SattiDaBeaver/System-From-Scratch/docs/01_architecture.md

# High-level:

## Word size

## Endianness
- Little Endian

## Memory Map

| Base Address | End Address  | Size | Description |
|---|---|---|---|
| `0x00000000` | `0x00003FFF` | 16KB | DP BRAM (boot + program) |
| `0x10000000` | `0x10000000` | 4B | UART TX data |
| `0x10000004` | `0x10000004` | 4B | UART RX data |
| `0x10000008` | `0x10000008` | 4B | UART status (bit 0 = TX_busy, bit 1 = RX_done) |
| `0x20000000` | `0x20000000` | 4B | VGA_CTRL (bit0 = DOUBLE_BUF_EN, bit1 = SWAP) |
| `0x20000004` | `0x20000004` | 4B | VGA_STATUS, read-only (bit0 = SWAP_PENDING) |
| `0x20001000` | `0x20001FFF` | 4KB page (2400B used) | VGA draw buffer -- fixed logical address, remapped internally by `vga_framebuffer.sv` to whichever physical buffer software should be drawing into (the scanned-out buffer in single-buffer mode, the back buffer in double-buffer mode) |
| `0x20002000` | `0x20002FFF` | 4KB page (2400B used) | VGA debug-peek buffer -- fixed logical address, always maps to the physical buffer NOT currently mapped at the draw address; lets `reg_debugger.py` READ_MEM inspect the other buffer regardless of mode |
| `0x30000000` | `0x30000000` | 4B | Timer RELOAD (rw) |
| `0x30000004` | `0x30000004` | 4B | Timer CTRL (rw, bit0 = EN) |
| `0x30000008` | `0x30000008` | 4B | Timer STATUS (bit0 = pending, write-1-to-clear) |

### VGA framebuffer (`src/peripherals/vga_framebuffer.sv`)

160x120, 1bpp (monochrome), two physical buffers (double-buffer capable,
~2.4KB each / ~4.8KB total -- negligible against MAX10 10M50's ~200KB
M9K budget). Row-major, row stride 5 words (20B): pixel `(x,y)` -> word
`y*5 + x/32`, bit `x%32`. Self-contained module -- owns both physical
buffers, the draw/debug-peek address remapping, and VGA timing/scanout
internally; the top level only wires a slice of the dmem bus in (same
pattern as `uart_sel`/`debug_uart` today) plus `CLOCK_50`/hsync/vsync/rgb
out, no muxing logic lives in `riscv_top.sv` itself -- designed to be a
drop-in for other CPU-driven-VGA projects, not SoC-specific.

- **Single-buffer mode** (`DOUBLE_BUF_EN=0`): writes to the draw address
  hit the buffer currently being scanned out directly -- real-time,
  visible immediately, tearing possible. Useful for testing/quick
  iteration without waiting on a swap.
- **Double-buffer mode** (`DOUBLE_BUF_EN=1`): writes to the draw address
  hit the back buffer only. Writing `SWAP=1` requests a swap; the actual
  front/back flip is applied on the vsync edge that starts the next
  frame (never mid-scanout, so the swap itself can't tear), at which
  point `SWAP_PENDING` clears. Software's draw loop: draw into the back
  buffer, write `SWAP=1`, poll `SWAP_PENDING` until it clears, repeat.
- A `SWAP` write in single-buffer mode is a no-op (nothing to swap, not
  an error) -- lets software leave a `SWAP=1` write in place when
  toggling `DOUBLE_BUF_EN` without needing to special-case it.
- Clocking: the module runs directly off `CLOCK_50` (50MHz), not the
  divided-down 25MHz clock the core/UART/BRAM use -- an internal
  `CLK_DIV` parameter (default 2) generates a pixel-rate enable that
  gates only the H/V timing counters/scanout, not the bus-facing
  register/buffer read/write logic (which runs every `clk50` edge,
  unthrottled). No CDC synchronizers on the dmem-bus inputs: the core's
  `clk` is itself a toggle-FF driven directly off `clk50` (mesochronous,
  not truly asynchronous), so `clk50`-domain logic samples core-driven
  signals directly. Both physical buffers are `dp_ram_sync_read`
  instances (synchronous-read/write dual-port RAM, `src/peripherals/
  dp_ram_sync_read.sv`), not raw arrays, so Quartus reliably infers block
  RAM. Draw/peek buffer reads take 2 cycles (RAM's own registered
  output + an outer decode-delay register); VGA_CTRL/VGA_STATUS reads
  take the same 2 cycles for a uniform read contract.

## Register count

## Address space layout

## Interrupt model

Synchronous exceptions only: ECALL/EBREAK trap entry (mepc <- trapping
pc, mcause <- 11/3, pc <- mtvec) and MRET trap exit (pc <- mepc) are
implemented on both cores. On the pipelined core they resolve in EX like
a known-unconditional jump (folded into `ex_flush`/`next_pc`), with a
stall added ahead of them in ID for any still-in-flight CSR write to the
same `mtvec`/`mepc` they read.

Timer interrupts (pipelined core only): `src/peripherals/timer.sv` is a
simple periodic down-counter (RELOAD/CTRL.EN/STATUS.pending register
map at `0x30000000`, see the memory map above) that drives a level `irq`
output, wired into `riscv_core.sv` as `timer_irq` and mirrored
combinationally into `mip` bit 7 (MTIP). `irq_taken` is level-driven
(`mstatus.MIE && mie.MTIE && timer_irq`) rather than tied to a specific
instruction, checked against whatever instruction is currently resolving
in EX; it is gated only by an in-progress ECALL/EBREAK/MRET (never by an
ordinary taken branch/jal/jalr, since a tight self-loop resolves as a
taken jal every cycle and would otherwise make the interrupt
unreachable while spinning). A taken interrupt redirects to `mtvec`
(same vector traps already use -- no vectored mode), sets `mcause` to
`0x80000007` (machine timer interrupt), and stacks `mstatus`: `MPIE <-
MIE`, `MIE <- 0` on entry, restored (`MIE <- MPIE`, `MPIE <- 1`) on
MRET, so a handler can't be re-interrupted until it explicitly returns.

Not yet implemented: `mstatus` MIE/MPIE stacking and timer-interrupt
support on the frozen single-cycle core (`riscv_core_single_cycle.sv`)
-- deliberately out of scope for this pass, see `docs/04_pipeline_plan.md`
-- and any real privilege modes.

## Target clock frequency
