SattiDaBeaver/System-From-Scratch/fpga/riscv_top.sv

// CORE_TYPE selects which core RTL gets elaborated -- "PIPELINED" (default)
// for the in-development 5-stage riscv_core, or "SINGLE_CYCLE" for the
// frozen riscv_core_single_cycle golden model (see test/testbench/tb_diff.sv,
// which already differential-fuzzes the two side by side). Both modules
// share an identical port list, so this is a pure synthesis-time choice --
// no other RTL in this file depends on which one is selected. Override via
// Quartus's top-level parameter assignment (Assignment Editor, or
// `set_parameter -name CORE_TYPE "SINGLE_CYCLE"` in the QSF) before compiling.
module riscv_top #(
    parameter CORE_TYPE = "PIPELINED"
) (
    input  logic [9:0] SW,
    input  logic [1:0] KEY,
    input  logic       CLOCK_50,

    output logic [6:0] HEX5,
    output logic [6:0] HEX4,
    output logic [6:0] HEX3,
    output logic [6:0] HEX2,
    output logic [6:0] HEX1,
    output logic [6:0] HEX0,
    output logic [9:0] LEDR,

    output logic [3:0] VGA_R,
    output logic [3:0] VGA_G,
    output logic [3:0] VGA_B,
    output logic       VGA_HS,
    output logic       VGA_VS,

    inout  logic [15:0] ARDUINO_IO
);

    // ──────────────────────────────────────
    //  Clock and Reset
    // ──────────────────────────────────────
    // Single 25MHz system clock for everything (core, both UARTs, BRAM) --
    // the single-cycle core can't close timing at the full 50MHz CLOCK_50,
    // so rather than keep a separate core_clk/clk split (which needs a
    // clock-domain-crossing-aware STEP pulse for the debug UART), just
    // divide once and run the whole design off the divided clock. No CDC
    // anywhere in this design as a result.
    logic clk50;
    logic clk;
    logic rst;
    logic clk_div_toggle;

    assign clk50 = CLOCK_50;
    assign rst   = ~KEY[0];

    // Free-running, NOT gated by rst: every downstream module's own
    // synchronous reset (always_ff @(posedge clk) if (rst) ...) needs at
    // least one clk edge while rst is still asserted to actually latch its
    // reset values. Gating this divider on rst held clk_div_toggle (and
    // therefore clk) frozen at 0 for the whole reset window, so no
    // downstream sync-reset block ever saw a posedge to reset on -- e.g.
    // debug_uart's halt<=1'b1 on reset silently never took effect, on
    // hardware as well as in sim (see docs/dev_log.md).
    always_ff @(posedge clk50) begin
        clk_div_toggle <= ~clk_div_toggle;
    end

    assign clk = clk_div_toggle;  // CLOCK_50 / 2 = 25MHz

    // ──────────────────────────────────────
    //  Unused outputs tied off for now
    // ──────────────────────────────────────
    // assign HEX5 = 7'h7F;
    // assign HEX4 = 7'h7F;
    // assign HEX3 = 7'h7F;
    // assign HEX2 = 7'h7F;
    // assign HEX1 = 7'h7F;
    // assign HEX0 = 7'h7F;
    // assign LEDR = 10'b0;

    logic vga_hsync, vga_vsync, vga_mono_pixel;

    assign VGA_R  = {4{vga_mono_pixel}};
    assign VGA_G  = {4{vga_mono_pixel}};
    assign VGA_B  = {4{vga_mono_pixel}};
    assign VGA_HS = vga_hsync;
    assign VGA_VS = vga_vsync;

    // ──────────────────────────────────────
    //  Core Interface Wires
    // ──────────────────────────────────────
    logic [31:0] imem_addr;
    logic [31:0] imem_rdata;
    logic [31:0] dmem_addr;
    logic [31:0] dmem_wdata;
    logic        dmem_we;
    logic        dmem_re;
    logic [3:0]  dmem_byteena;
    logic [31:0] ld_data;
    logic [4:0]  dbg_reg_addr;
    logic [31:0] dbg_reg_data;
    logic [31:0] pc_dbg;
    logic        halt;

    // Debug-driven CSR read (async, combinational on the core side).
    logic [11:0] dbg_csr_addr;
    logic [31:0] dbg_csr_data;

    // req/vld memory handshake -- only riscv_core (PIPELINED) has these
    // ports; for CORE_TYPE=SINGLE_CYCLE dmem_req is tied to dmem_re below
    // so dmem_rvalid's trigger is unchanged from today for that branch.
    logic        imem_req;
    logic        dmem_req;

    // Debug-UART-driven BRAM port B access (hardware bootloader) -- see
    // the BRAM port B mux below.
    logic [31:0] dbg_mem_addr;
    logic [31:0] dbg_mem_wdata;
    logic        dbg_mem_we;
    logic        dbg_mem_valid;
    logic [31:0] dbg_mem_rdata;

    // Debug-driven MMIO peripheral read (READ_MMIO) -- see the periph_addr
    // mux below, which steers uart_sel/timer_sel's decode off dbg_mmio_addr
    // instead of dmem_addr while dbg_mmio_valid is high.
    logic [31:0] dbg_mmio_addr;
    logic        dbg_mmio_valid;
    logic [31:0] dbg_mmio_rdata;

    // ──────────────────────────────────────
    //  UART Wires
    // ──────────────────────────────────────
    logic        uart_tx;
    logic        uart_rx;
    logic        uart_tx_en;
    logic        uart_tx_busy;
    logic        uart_tx_done;
    logic        uart_rx_done;
    logic        uart_rx_parity_err;
    logic [7:0]  uart_tx_data;
    logic [7:0]  uart_rx_data;

    // clk_per_bit for 115200 baud @ 25MHz
    // 25_000_000 / 115200 = 217
    localparam CLK_PER_BIT = 16'd217;

    // ──────────────────────────────────────
    //  Debug UART Wires
    // ──────────────────────────────────────
    logic dbg_rx;
    logic dbg_tx;

    // ARDUINO_IO[0] = RX (input), ARDUINO_IO[1] = TX (output) -- single
    // external serial link, shared by both the program UART and the debug
    // UART. SW[0] picks which one is actually connected to the pins, so
    // switching between "talk to my program" and "halt/step/read regs"
    // is a switch flip instead of moving a cable between ARDUINO headers.
    assign uart_rx = SW[0] ? 1'b1 : ARDUINO_IO[0];  // idle-high when not selected
    assign dbg_rx  = SW[0] ? ARDUINO_IO[0] : 1'b1;
    assign ARDUINO_IO[1] = SW[0] ? dbg_tx : uart_tx;

    // ──────────────────────────────────────
    //  Address Decoder
    // ──────────────────────────────────────
    logic bram_sel;
    logic uart_sel;
    logic vga_sel;
    logic timer_sel;

    // Debug READ_MMIO steers uart_sel/timer_sel's decode (and the address
    // fed to those peripherals below) off dbg_mmio_addr instead of
    // dmem_addr while dbg_mmio_valid is high, mirroring how dbg_mem_valid
    // already steers BRAM port B off dbg_mem_addr. Falls back to dmem_addr
    // whenever dbg_mmio_valid is low, so normal core operation is
    // unaffected. VGA is intentionally excluded from this mux -- READ_MMIO
    // doesn't cover it (see debug_uart.sv's header comment) -- so vga_sel
    // stays on dmem_addr unconditionally.
    logic [31:0] periph_addr;
    assign periph_addr = dbg_mmio_valid ? dbg_mmio_addr : dmem_addr;

    assign bram_sel  = (dmem_addr[31:16]   == 16'h0000);    // 0x00000000 - 0x00003FFF
    assign uart_sel  = (periph_addr[31:4]  == 28'h1000000); // 0x10000000 - 0x1000000F
    assign vga_sel   = (dmem_addr[31:16]   == 16'h2000);    // 0x20000000 - 0x2000FFFF
    assign timer_sel = (periph_addr[31:16] == 16'h3000);    // 0x30000000 - 0x3000FFFF

    // ──────────────────────────────────────
    //  Memory-read valid tracking (real BRAM registers its read address,
    //  so imem_rdata/bram_rd_data lag imem_addr/dmem_addr by one cycle --
    //  imem_vld/dmem_vld below feed both cores' native req/vld stall logic.)
    // ──────────────────────────────────────
    logic imem_rvalid;
    logic dmem_rvalid;

    // imem_addr is held stable by both cores while stalled, so "did the
    // address I'm driving into the BRAM change since last cycle" is a
    // well-defined, core-agnostic proxy for "has the one-cycle registered
    // read latency elapsed" -- fixes the KNOWN BUG from
    // docs/04_pipeline_plan.md §6.2, where imem_rvalid was hardwired 1'b1
    // and never actually tracked REGISTERED_ADDR=1 latency.
    logic [31:0] imem_addr_prev;
    logic        imem_addr_changed;

    always_ff @(posedge clk) begin
        imem_addr_prev <= imem_addr;
    end
    assign imem_addr_changed = (imem_addr != imem_addr_prev);

    // Combinational, not registered -- imem_addr_changed already compares
    // this cycle's address against last cycle's, so it's already the
    // one-cycle-latency signal. Registering it again added a spurious
    // extra cycle where imem_rvalid reported valid for stale data right
    // after a jump (two consecutive address changes), letting the core
    // re-execute/skip instructions around jump targets.
    assign imem_rvalid = !imem_addr_changed;

    // Same bug class as imem_rvalid above, but on dmem: dmem_rvalid <= dmem_req
    // only tracked whether *some* request was pending last cycle, not whether
    // THIS address had a cycle to register. Back-to-back dmem ops to different
    // addresses (e.g. a store immediately followed by a load) kept dmem_req
    // high across the address change, so dmem_rvalid was already asserted on
    // the very first cycle of the new address -- the core read stale
    // bram_rd_data from the prior address one cycle too early. Mirror
    // imem_rvalid's address-change tracking instead.
    logic [31:0] dmem_addr_prev;
    logic        dmem_addr_changed;

    always_ff @(posedge clk) begin
        dmem_addr_prev <= dmem_addr;
    end
    assign dmem_addr_changed = (dmem_addr != dmem_addr_prev);
    assign dmem_rvalid = dmem_req && !dmem_addr_changed;

    // ──────────────────────────────────────
    //  Load Data Mux
    // ──────────────────────────────────────
    logic [31:0] bram_rd_data;
    logic [31:0] uart_rd_data;
    logic [31:0] vga_rd_data;
    logic [31:0] timer_rd_data;
    logic        timer_irq;

    // UART read data mux -- indexed off periph_addr so a debug READ_MMIO
    // (which steers uart_sel/periph_addr, see above) reads the same
    // TX/RX/status registers the core itself would see at that address.
    always_comb begin
        uart_rd_data = 32'b0;
        casez (periph_addr[3:2])
            2'b00: uart_rd_data = {24'b0, uart_tx_data};           // TX data
            2'b01: uart_rd_data = {24'b0, uart_rx_data};           // RX data
            2'b10: uart_rd_data = {30'b0, uart_rx_done,
                                           uart_tx_busy};           // status
            default: uart_rd_data = 32'b0;
        endcase
    end

    // Final load data mux
    always_comb begin
        if      (bram_sel)  ld_data = bram_rd_data;
        else if (uart_sel)  ld_data = uart_rd_data;
        else if (vga_sel)   ld_data = vga_rd_data;
        else if (timer_sel) ld_data = timer_rd_data;
        else                ld_data = 32'b0;
    end

    // dbg_mmio_rdata mirrors the same uart_sel/timer_sel result the core's
    // own ld_data mux would produce, but off periph_addr's debug-steered
    // decode -- VGA is intentionally excluded (see periph_addr comment
    // above), so an out-of-range READ_MMIO address reads as 0.
    always_comb begin
        if      (uart_sel)  dbg_mmio_rdata = uart_rd_data;
        else if (timer_sel) dbg_mmio_rdata = timer_rd_data;
        else                dbg_mmio_rdata = 32'b0;
    end

    // ──────────────────────────────────────
    //  UART Write Decode
    // ──────────────────────────────────────
    always_comb begin
        uart_tx_en   = 1'b0;
        uart_tx_data = 8'b0;
        if (uart_sel && dmem_we) begin
            casez (dmem_addr[3:2])
                2'b00: begin
                    uart_tx_data = dmem_wdata[7:0];
                    uart_tx_en   = 1'b1;
                end
                default: ;
            endcase
        end
    end

    // 7 seg display
    logic [3:0] h0;
    logic [3:0] h1;
    logic [3:0] h2;
    logic [3:0] h3;
    logic [3:0] h4;
    logic [3:0] h5;

    hex_display u_hex0 (.value(h0), .HEX(HEX0));
    hex_display u_hex1 (.value(h1), .HEX(HEX1));
    hex_display u_hex2 (.value(h2), .HEX(HEX2));
    hex_display u_hex3 (.value(h3), .HEX(HEX3));
    hex_display u_hex4 (.value(h4), .HEX(HEX4));
    hex_display u_hex5 (.value(h5), .HEX(HEX5));

    assign h0 = imem_rdata[3:0];
    assign h1 = imem_rdata[7:4];
    assign h2 = imem_rdata[11:8];
    assign h3 = imem_rdata[15:12];
    assign h4 = imem_rdata[19:16];
    assign h5 = imem_rdata[23:20];

    assign LEDR[9:0] = {~dbg_rx, ~dbg_tx, 1'b0, imem_addr[8:2]};

    // ──────────────────────────────────────
    //  DP BRAM
    // ──────────────────────────────────────
    // Port B is normally the core's data memory port; while the debug
    // UART is servicing WRITE_MEM/READ_MEM (dbg_mem_valid), it takes over
    // port B instead. debug_uart only ever asserts dbg_mem_valid while
    // halt is set (see debug_uart.sv), so this can't race a running
    // program's own dmem accesses.
    logic [31:0] bram_addr_b;
    logic [31:0] bram_data_b;
    logic        bram_we_b;
    logic [3:0]  bram_byteena_b;

    assign bram_addr_b = dbg_mem_valid ? dbg_mem_addr  : dmem_addr;
    assign bram_data_b = dbg_mem_valid ? dbg_mem_wdata : dmem_wdata;
    assign bram_we_b   = dbg_mem_valid ? dbg_mem_we    : (dmem_we && bram_sel);
    // debug UART's WRITE_MEM is always a full 32-bit word (see
    // debug_uart.sv's mem_wdata assembly), so it always uses a full mask;
    // the core's own dmem_byteena only applies to its own dmem writes.
    assign bram_byteena_b = dbg_mem_valid ? 4'b1111 : dmem_byteena;
    assign dbg_mem_rdata = bram_rd_data;

    dp_ram u_bram (
        .clock      (clk),
        // Port A — instruction fetch
        .address_a  (imem_addr[13:2]),
        .data_a     (32'b0),
        .wren_a     (1'b0),
        .byteena_a  (4'b1111),
        .q_a        (imem_rdata),
        // Port B — data memory / debug-UART hardware bootloader
        .address_b  (bram_addr_b[13:2]),
        .data_b     (bram_data_b),
        .wren_b     (bram_we_b),
        .byteena_b  (bram_byteena_b),
        .q_b        (bram_rd_data)
    );

    // ──────────────────────────────────────
    //  UART
    // ──────────────────────────────────────
    uart #(
        .CLK_BITS    (16),
        .DATA_WIDTH  (8),
        .PARITY_BITS (0),
        .STOP_BITS   (2)
    ) u_uart (
        .clk            (clk),
        .rst            (rst),
        .clk_per_bit    (CLK_PER_BIT),
        .TX_dataIn      (uart_tx_data),
        .TX_en          (uart_tx_en),
        .RX_dataIn      (uart_rx),
        .TX_out         (uart_tx),
        .TX_done        (uart_tx_done),
        .TX_busy        (uart_tx_busy),
        .RX_dataOut     (uart_rx_data),
        .RX_done        (uart_rx_done),
        .RX_parityError (uart_rx_parity_err)
    );

    // ──────────────────────────────────────
    //  VGA Framebuffer
    // ──────────────────────────────────────
    // Runs off the full-rate 50MHz board clock directly (not the divided
    // `clk` the core/UART/BRAM use) -- CLK_DIV=2 internally regenerates
    // the same 25MHz pixel-timing rate this design already relied on, per
    // README.md's clock-divider note. No CDC synchronizers needed on the
    // sel/addr/wdata/we/re inputs below: `clk` is itself just a toggle-FF
    // off `clk50` (see the divider comment above), so it's mesochronous
    // with clk50, not a genuinely independent/asynchronous clock domain.
    vga_framebuffer #(
        .CLK_DIV (2)
    ) u_vga (
        .clk    (clk50),
        .rst    (rst),
        .sel    (vga_sel),
        .addr   (dmem_addr[15:0]),
        .wdata  (dmem_wdata),
        .we     (dmem_we),
        .re     (dmem_re),
        .rdata  (vga_rd_data),
        .hsync  (vga_hsync),
        .vsync  (vga_vsync),
        .mono_pixel (vga_mono_pixel)
    );

    // ──────────────────────────────────────
    //  Timer (interrupt source)
    // ──────────────────────────────────────
    timer u_timer (
        .clk    (clk),
        .rst    (rst),
        .sel    (timer_sel),
        .addr   (periph_addr[3:0]),
        .wdata  (dmem_wdata),
        .we     (dmem_we),
        // OR in dbg_mmio_valid -- timer's own rdata mux gates on re, and
        // the core's dmem_re won't be asserted during a debug READ_MMIO
        // (the core may well be halted), so without this a debug timer
        // peek would always read back 0.
        .re     (dmem_re || dbg_mmio_valid),
        .rdata  (timer_rd_data),
        .irq    (timer_irq)
    );

    // ──────────────────────────────────────
    //  RISC-V Core
    // ──────────────────────────────────────
    // Both cores now share the same req/vld memory-timing contract --
    // imem_req/imem_vld, dmem_req/dmem_vld -- so both stall internally for
    // exactly as long as the BRAM's registered-address latency takes,
    // instead of an external whole-core halt wrapper (see
    // docs/04_pipeline_plan.md §4/§6.1).
    generate
        if (CORE_TYPE == "SINGLE_CYCLE") begin : g_core
            riscv_core_single_cycle u_core (
                .clk        (clk),
                .rst        (rst),
                .halt       (halt & KEY[1]),
                .imem_addr  (imem_addr),
                .imem_rdata (imem_rdata),
                .imem_req   (imem_req),
                .imem_vld   (imem_rvalid),
                .dmem_addr  (dmem_addr),
                .dmem_wdata (dmem_wdata),
                .dmem_we    (dmem_we),
                .dmem_re    (dmem_re),
                .dmem_byteena(dmem_byteena),
                .ld_data    (ld_data),
                .dmem_req   (dmem_req),
                .dmem_vld   (dmem_rvalid),
                .dbg_reg_addr(dbg_reg_addr),
                .dbg_reg_data(dbg_reg_data),
                .dbg_csr_addr(dbg_csr_addr),
                .dbg_csr_data(dbg_csr_data),
                .pc_dbg     (pc_dbg),
                ._bogus     (1'b0)
            );
        end else begin : g_core
            riscv_core u_core (
                .clk        (clk),
                .rst        (rst),
                .halt       (halt & KEY[1]),
                .imem_addr  (imem_addr),
                .imem_rdata (imem_rdata),
                .imem_req   (imem_req),
                .imem_vld   (imem_rvalid),
                .dmem_addr  (dmem_addr),
                .dmem_wdata (dmem_wdata),
                .dmem_we    (dmem_we),
                .dmem_re    (dmem_re),
                .dmem_byteena(dmem_byteena),
                .ld_data    (ld_data),
                .dmem_req   (dmem_req),
                .dmem_vld   (dmem_rvalid),
                .dbg_reg_addr(dbg_reg_addr),
                .dbg_reg_data(dbg_reg_data),
                .dbg_csr_addr(dbg_csr_addr),
                .dbg_csr_data(dbg_csr_data),
                .pc_dbg     (pc_dbg),
                .timer_irq  (timer_irq),
                ._bogus     (1'b0)
            );
        end
    endgenerate

    // ──────────────────────────────────────
    //  Debug UART
    // ──────────────────────────────────────
    // Core, program UART, and debug UART all now share one clk (25MHz) --
    // no more core_clk/clk split, so STEP's one-cycle halt-drop pulse is
    // always exactly one core clock cycle, unconditionally.
    debug_uart #(
        .CLK_BITS (16)
    ) u_debug_uart (
        .clk          (clk),
        .rst          (rst),
        .clk_per_bit  (CLK_PER_BIT),
        .dbg_rx       (dbg_rx),
        .dbg_tx       (dbg_tx),
        .dbg_reg_addr (dbg_reg_addr),
        .dbg_reg_data (dbg_reg_data),
        .pc_dbg       (pc_dbg),
        .dbg_csr_addr (dbg_csr_addr),
        .dbg_csr_data (dbg_csr_data),
        .dbg_mem_addr  (dbg_mem_addr),
        .dbg_mem_wdata (dbg_mem_wdata),
        .dbg_mem_we    (dbg_mem_we),
        .dbg_mem_valid (dbg_mem_valid),
        .dbg_mem_rdata (dbg_mem_rdata),
        .dbg_mmio_addr  (dbg_mmio_addr),
        .dbg_mmio_valid (dbg_mmio_valid),
        .dbg_mmio_rdata (dbg_mmio_rdata),
        .halt         (halt)
    );

endmodule
