SattiDaBeaver/System-From-Scratch/test/testbench/tb_diff.sv

// tests/testbench/tb_diff.sv
//
// Differential testbench: instantiates the core under active development
// (riscv_core, pipelined once that work lands) side by side with the
// frozen, verified riscv_core_single_cycle golden model. Each gets its own
// imem/dmem arrays -- imem is loaded identically into both by the test, and
// dmem starts identical -- so any divergence in dmem contents or regfile
// state after both cores converge (see utils.await_convergence) is a real
// behavioral mismatch, not a shared-state artifact.

module tb_diff #(
    parameter IMEM_DEPTH = 256,   // 256 x 4 bytes = 1KB
    parameter DMEM_DEPTH = 256    // 256 x 4 bytes = 1KB
) (
    input  logic        clk,
    input  logic        rst
);

    // ---- DUT: core under test (pipeline, once implemented) ----
    logic [31:0] imem       [0:IMEM_DEPTH-1];
    logic [31:0] dmem       [0:DMEM_DEPTH-1];
    logic [31:0] imem_addr;
    logic [31:0] imem_rdata;
    logic [31:0] dmem_addr;
    logic [31:0] dmem_wdata;
    logic        dmem_we;
    logic [3:0]  dmem_byteena;
    logic        dmem_re;
    logic [31:0] ld_data;
    logic [4:0]  dbg_reg_addr;
    logic [31:0] dbg_reg_data;
    logic [31:0] pc_dbg;

    // Debug CSR read -- no debug_uart instance here, just expose for
    // direct signal access (dut.u_core.dbg_csr_data), mirroring
    // tb_core.sv's treatment.
    logic [11:0] dbg_csr_addr;
    logic [31:0] dbg_csr_data;

    riscv_core #(
        .ISA ("RV32I")
    ) u_core (
        .clk         (clk),
        .rst         (rst),
        .halt        (1'b0),
        .imem_addr   (imem_addr),
        .imem_rdata  (imem_rdata),
        .imem_req    (),
        .imem_vld    (1'b1),
        .dmem_addr   (dmem_addr),
        .dmem_wdata  (dmem_wdata),
        .dmem_we     (dmem_we),
        .dmem_byteena(dmem_byteena),
        .dmem_re     (dmem_re),
        .ld_data     (ld_data),
        .dmem_req    (),
        .dmem_vld    (1'b1),
        .dbg_reg_addr(dbg_reg_addr),
        .dbg_reg_data(dbg_reg_data),
        .dbg_csr_addr(dbg_csr_addr),
        .dbg_csr_data(dbg_csr_data),
        .pc_dbg      (pc_dbg),
        .timer_irq   (1'b0)
    );

    assign imem_rdata = imem[imem_addr[31:2]];
    assign ld_data    = dmem[dmem_addr[31:2]];

    always_ff @(posedge clk) begin
        if (dmem_we) begin
            if (dmem_byteena[0]) dmem[dmem_addr[31:2]][7:0]   <= dmem_wdata[7:0];
            if (dmem_byteena[1]) dmem[dmem_addr[31:2]][15:8]  <= dmem_wdata[15:8];
            if (dmem_byteena[2]) dmem[dmem_addr[31:2]][23:16] <= dmem_wdata[23:16];
            if (dmem_byteena[3]) dmem[dmem_addr[31:2]][31:24] <= dmem_wdata[31:24];
        end
    end

    // ---- Golden model: frozen pre-pipeline single-cycle core ----
    logic [31:0] imem_ref       [0:IMEM_DEPTH-1];
    logic [31:0] dmem_ref       [0:DMEM_DEPTH-1];
    logic [31:0] imem_addr_ref;
    logic [31:0] imem_rdata_ref;
    logic [31:0] dmem_addr_ref;
    logic [31:0] dmem_wdata_ref;
    logic        dmem_we_ref;
    logic [3:0]  dmem_byteena_ref;
    logic        dmem_re_ref;
    logic [31:0] ld_data_ref;
    logic [4:0]  dbg_reg_addr_ref;
    logic [31:0] dbg_reg_data_ref;
    logic [31:0] pc_dbg_ref;

    logic [11:0] dbg_csr_addr_ref;
    logic [31:0] dbg_csr_data_ref;

    riscv_core_single_cycle #(
        .ISA ("RV32I")
    ) u_core_ref (
        .clk         (clk),
        .rst         (rst),
        .halt        (1'b0),
        .imem_addr   (imem_addr_ref),
        .imem_rdata  (imem_rdata_ref),
        .imem_req    (),
        .imem_vld    (1'b1),
        .dmem_addr   (dmem_addr_ref),
        .dmem_wdata  (dmem_wdata_ref),
        .dmem_we     (dmem_we_ref),
        .dmem_byteena(dmem_byteena_ref),
        .dmem_re     (dmem_re_ref),
        .ld_data     (ld_data_ref),
        .dmem_req    (),
        .dmem_vld    (1'b1),
        .dbg_reg_addr(dbg_reg_addr_ref),
        .dbg_reg_data(dbg_reg_data_ref),
        .dbg_csr_addr(dbg_csr_addr_ref),
        .dbg_csr_data(dbg_csr_data_ref),
        .pc_dbg      (pc_dbg_ref)
    );

    assign imem_rdata_ref = imem_ref[imem_addr_ref[31:2]];
    assign ld_data_ref    = dmem_ref[dmem_addr_ref[31:2]];

    always_ff @(posedge clk) begin
        if (dmem_we_ref) begin
            if (dmem_byteena_ref[0]) dmem_ref[dmem_addr_ref[31:2]][7:0]   <= dmem_wdata_ref[7:0];
            if (dmem_byteena_ref[1]) dmem_ref[dmem_addr_ref[31:2]][15:8]  <= dmem_wdata_ref[15:8];
            if (dmem_byteena_ref[2]) dmem_ref[dmem_addr_ref[31:2]][23:16] <= dmem_wdata_ref[23:16];
            if (dmem_byteena_ref[3]) dmem_ref[dmem_addr_ref[31:2]][31:24] <= dmem_wdata_ref[31:24];
        end
    end

endmodule
