SattiDaBeaver/System-From-Scratch/(commit log)

2026-05-25 added dp_ram IP, uart, and top wrapper
2026-05-29 fixed pc syntax bug (reset bug is still present)
    [riscv_core.sv]
2026-07-26 added vga.sv and verified test_full (via step, resume bug)
    [dp_ram_model.sv]
2026-07-26 added vga.sv and verified test_full on hardawre (via step, resume fails)
    [debug_uart.sv, reg_debugger.py, riscv_core.sv, riscv_core_single_cycle.sv, riscv_top.sv, tb_diff.sv]
2026-07-29 fix read/vld + notes in readme
    [riscv_core.sv, riscv_core_single_cycle.sv, riscv_top.sv, tb_diff.sv, tb_top.sv, tb_vga.sv]
2026-08-01 web debugger (assembler does not work on web)
    [dp_ram_model.sv, riscv_core.sv, riscv_core_single_cycle.sv, riscv_top.sv, tb_core.sv, tb_diff.sv, tb_soc.sv]
2026-08-01 web debugger (assembler does not work)
    [crit_path_estimate.py, debug_uart.sv, reg_debugger.py, riscv_core.sv, riscv_top.sv]
